Emusinse/AMP_Electronics/README.md

# AMP_Electronics
Custom speaker amplifier using TPA3126 IC

## Aim
This project aims to create a Class D speaker amplifier capabile of driving a set of 50W speakers. This is a personal prokect to replace a cheap 100W amps for a set of desk speakers,
Micca MB42.

## Requirements
- 2 x 50W outputs
- small form factor, smaller than 100mm x 100mm, allows cheaper PCBs
- Volume control, power switch
- AUX in, potentially RCA
- spring termiinal output
- Class D amplifier
