Emusinse/AMP_Electronics/Amp.kicad_pcb

## KiCad design Amp.kicad_pcb (2021-02-23)

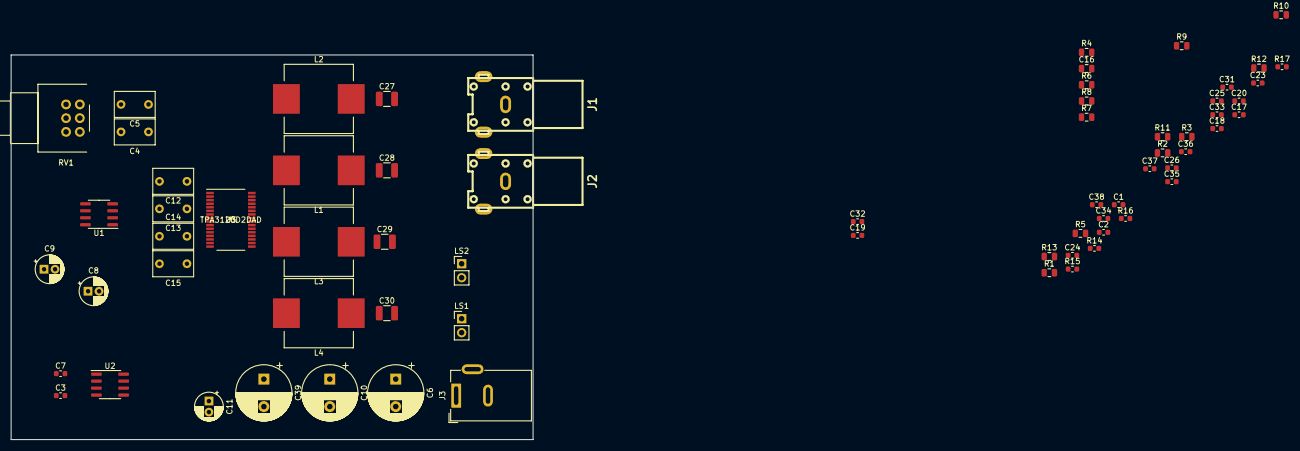
[picture p1: board Amp.kicad_pcb from above]

Board: 2 copper layers, 95.0 x 70.0 mm, 67 parts (0 on the bottom side), 44 nets, no tracks yet.

Parts:
C1, C7, C19, C20: 100n; C_0603_1608Metric
C2, C17, C18, C31, C32, C33, C34: 1n; C_0603_1608Metric
C3: 330n; C_0603_1608Metric
C4, C5, C12, C13, C14, C15: 1u; C_Rect_L7.2mm_W4.5mm_P5.00mm_FKS2_FKP2_MKS2_MKP2
C6, C10, C39: 220uf; CP_Radial_D10.0mm_P5.00mm
C8, C9, C11: 10u; CP_Radial_D5.0mm_P2.00mm
C16: 1u; C_0805_2012Metric
C23, C24, C25, C26: 220n; C_0603_1608Metric
C27, C28, C29, C30: 680n; C_1210_3225Metric
C35, C36, C37, C38: 10n; C_0603_1608Metric
J1, J2: Conn_Coaxial; rca
J3: Barrel_Jack; BarrelJack_Wuerth_6941xx301002
L1, L2, L3, L4: 10u; L_Wuerth_WE-PD-Typ-LS_Handsoldering
LS1, LS2: L; PinHeader_1x02_P2.54mm_Vertical
R1, R2, R7, R8: 1k; R_0805_2012Metric
R3, R4, R9, R10: 47k; R_0805_2012Metric
R5, R6: 680; R_0805_2012Metric
R11, R13: 100k; R_0805_2012Metric
R12: 20k; R_0805_2012Metric
R14, R15, R16, R17: 10R; R_0603_1608Metric
RV1: R_POT_Dual-Device; Potentiometer_Bourns_PTD90_Double
U1: NE5532; SOIC-8_3.9x4.9mm_P1.27mm
U2: MC78L12_SO8; SOIC-8_3.9x4.9mm_P1.27mm
U3: TPA3126D2DAD

Connections:
+12V: C1.2, C2.1, C7.1, U1.8, U2.1
/LIN: C14.2, R10.2
/RIN: C12.2, R9.2
GNDA: C1.1, C2.2, C8.2, C9.2, C13.2, C15.2, C27.2, C28.1, C29.2, C30.1, C31.2, C32.1, C33.2, C34.1, J1.2, J2.2, R3.1, R4.1, R14.2, R15.1, R16.2, R17.1, RV1.3, RV1.6, U1.4
GNDD: C3.2, C6.2, C7.2, C10.2, C11.2, C16.2, C17.2, C18.2, C19.2, C20.2, C39.2, J3.2, R12.2, R13.1, U2.2, U2.3, U2.6, U2.7, U3.9, U3.13, U3.14, U3.15, U3.16, U3.22, U3.25, U3.28
unnamed: C4.1, R1.2
unnamed: C4.2, RV1.2
unnamed: C5.1, R2.2
unnamed: C5.2, RV1.5
unnamed: C8.1, R5.1
unnamed: C9.1, R6.1
unnamed: C6.1, C10.1, C11.1, C39.1, J3.1
unnamed: C12.1, U3.4
unnamed: C13.1, U3.5
unnamed: C14.1, U3.10
unnamed: C15.1, U3.11
unnamed: C16.1, R11.1, U3.1, U3.6, U3.7
unnamed: C23.1, L1.2, U3.29
unnamed: C23.2, U3.30
unnamed: C24.1, L2.2, U3.27
unnamed: C24.2, U3.26
unnamed: C25.1, L3.2, U3.23
unnamed: C25.2, U3.24
unnamed: C26.1, L4.2, U3.21
unnamed: C26.2, U3.20
unnamed: C27.1, C31.1, C35.1, L1.1, LS1.1
unnamed: C28.2, C32.2, C36.2, L2.1, LS1.2
unnamed: C29.1, C33.1, C37.1, L3.1, LS2.1
unnamed: C30.2, C34.2, C38.2, L4.1, LS2.2
unnamed: C35.2, R14.1
unnamed: C36.1, R15.2
unnamed: C37.2, R16.1
unnamed: C38.1, R17.2
unnamed: J1.1, RV1.1
unnamed: J2.1, RV1.4
unnamed: R1.1, R3.2, U1.3
unnamed: R2.1, R4.2, U1.5
unnamed: R5.2, R7.2, U1.2
unnamed: R6.2, R8.2, U1.6
unnamed: R7.1, R9.1, U1.1
unnamed: R8.1, R10.1, U1.7
unnamed: R11.2, R12.1, U3.8
unnamed: R13.2, U3.12
VCC: C3.1, C17.1, C18.1, C19.1, C20.1, U2.8, U3.17, U3.18, U3.19, U3.31, U3.32
